sundw2014/caregiver/(list of files, drawings)

Other design files:
PCB/motorServoDriver.PcbDoc
PCB/motorServoDriver.PrjPcb
PCB/motorServoDriver.SchDoc
