sundw2014/caregiver/stm32F1/Project/inc/common.h

#ifndef _COMMON_H
#define _COMMON_H

#include "stm32f10x.h"
#include "motor.h"
#include "servo.h"
#include "receiver.h"
#include "usart.h"
#include "delay.h"
#include "rgbSensor.h"

//defines
#define USE_BT
// #define USE_RECEIVER

#endif
