sundw2014/caregiver/(commit log)

2016-09-04 PCB 1.0
    [motorServoDriver.PcbDoc, motorServoDriver.PrjPcb, motorServoDriver.SchDoc]
2016-09-04 PCB 3.0, test code
    [motorServoDriver.PcbDoc, motorServoDriver.SchDoc]
2016-09-11 接口说明
2016-10-07 sensor doc
